d-el/PS3604L/README.md

# PS3604L

## Overview

The PS3604L is a 144 Watt, high performance dc power supply with output current measurement capability in the microampere range.
Combination of bench-top and system features in these dc source.
For more photos to /Photo.

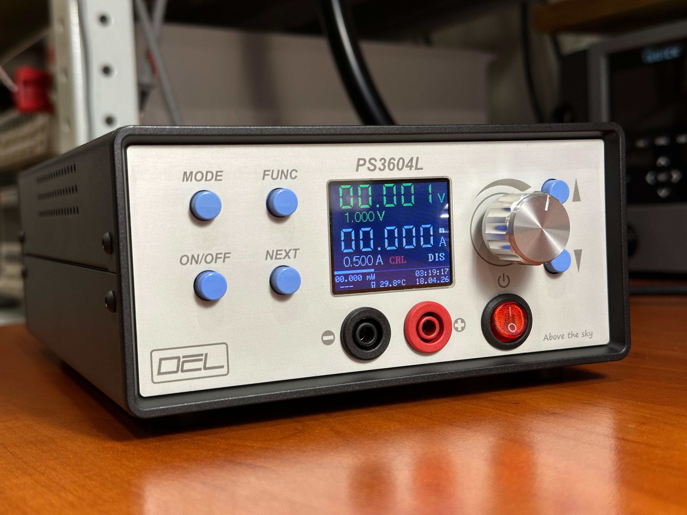
[picture p1: Pictures/face.jpg]


### Convenient bench-top features

- Up to 144 Watts output power
- Easy to use knob for voltage and current settings
- IPS 160x128 pixel front panel display
- Excellent load and line regulation; low ripple and noise
- Measurement capability down to microampere levels
- Light weight

### Flexible system features

- 10/100BASE-T Ethernet

- Modbus TCP for remote programming

- Web interface for monitoring

## Specifications

Unless otherwise noted, specifications apply when measured after a 30-minute warm-up period.

### Performance Specifications

| Parameter | | |
| :--- | ---: | :---: |
| **Output Ratings** | Voltage:<br />Current: | 0 – 36 V<br />0 – 4 A |
| **Programming Accuracy**<br/>(@ 25°C ±5°C) | Voltage:<br />Current: | 5 mV<br />2mA |
| **DC Measurement Accuracy**<br />(@ 25°C ±5°C) | Voltage:<br />Current 0 – 1 mA:<br />Current 0.001 – 4 A: | 5 mV<br />0.01 mA<br />2 mA |
| **Ripple and Noise** | Voltage: (rms)<br />Current (rms): | 0.5 mV<br />1.5 mA |
| **Load Regulation** | TBD | TBD |
| **Line Regulation**<br/>(change in output voltage<br/>or current for any line<br/>change within ratings) | TBD | TBD |
| **Transient Response Time**<br />*1 | | < 50 μs |

1. For the output voltage to recover to its previous level within 0.1% of the voltage rating of the unit or 20 millivolts following a
   change in load current of up to 50% of the output current rating

Short term voltage accuracy:

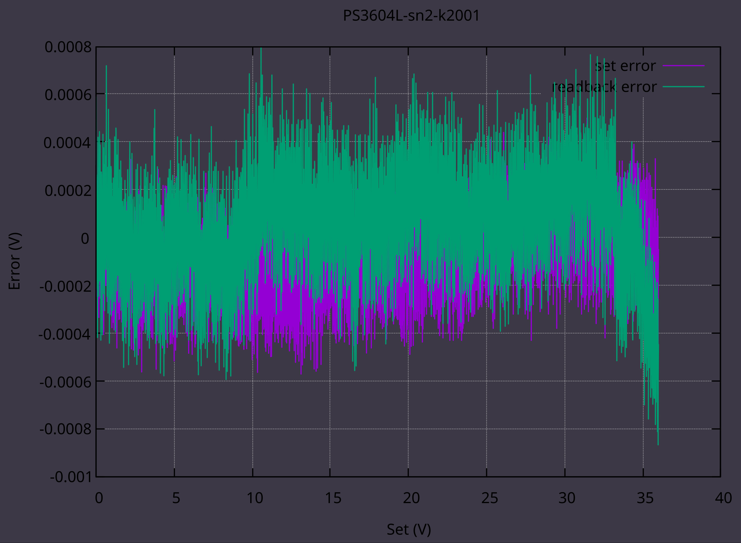
[picture p2: Pictures/Measured/ShortTermVoltAccuracy.JPG]


### Supplemental Characteristics

| Parameter | | |
| --- | ---: | :---: |
| **Input Rating**<br/>(at full load ) | 230 Vac mains: | 230 Vac nominal, 50/60 Hz, 0.85A, 200 VA max. |
| **Average Programming<br/>Resolution** | Voltage (panel):<br />Voltage (remote)<br />Current (panel):<br />Current (remote) | 10 mV<br<br />1 mV<br />1 mA<br />0.1 mA |
| **Output Voltage Rise/Fall Time**<br/>(for a change from 10% to 90% or<br/>90% to 10% of the total excursion) | Rise<br />Fall | < 80 μs<br />< 10 μs |
| **Command Processing Time** | | 10 ms |
| **Isolation to Ground**<br/>(Maximum from either<br/>output terminal to chassis) | | 200 Vdc |
| **Dimensions** | Height:<br />Width:<br />Depth: | 78 mm<br />158 mm<br />268 mm |
| **Net weight** | | 3.850 kg |

------

## Structure

The device has the following modules: Transformer, Rectifier, Regulator, and Front Panel.
The Altium PCB projects can also be opened directly in ECAD Forge for quick browser-based inspection.

Overall structure:



------

## Rectifier

The PS3604LRCF rectifier board rectifies and filters the transformer outputs to provide the raw supply rails for the linear regulator.
Module [schematic](PCB/PS3604LRCF/output/PS3604LRCF.PDF), [ECAD][ecadforge-ps3604lrcf].

------

## Linear regulator

Regulator structure diagram:



Linear regulator is a separate module. Module mounted on back aluminum radiator.
Regulator is four level voltage regulator. Hardware CC/CV detector.
Controlled by STM32F337. Used AD4680 SAR 16bit (18bit oversampling mode) for measure voltage and current.
AD5060 16bit DAC use for current and voltage setpoint.
Fan speed proportional control for minimize sound noise.
Module communicate by UART ModBus.
Module [schematic](PCB/PS3604LR/output/PS3604LR.PDF), [ECAD][ecadforge-ps3604lr].
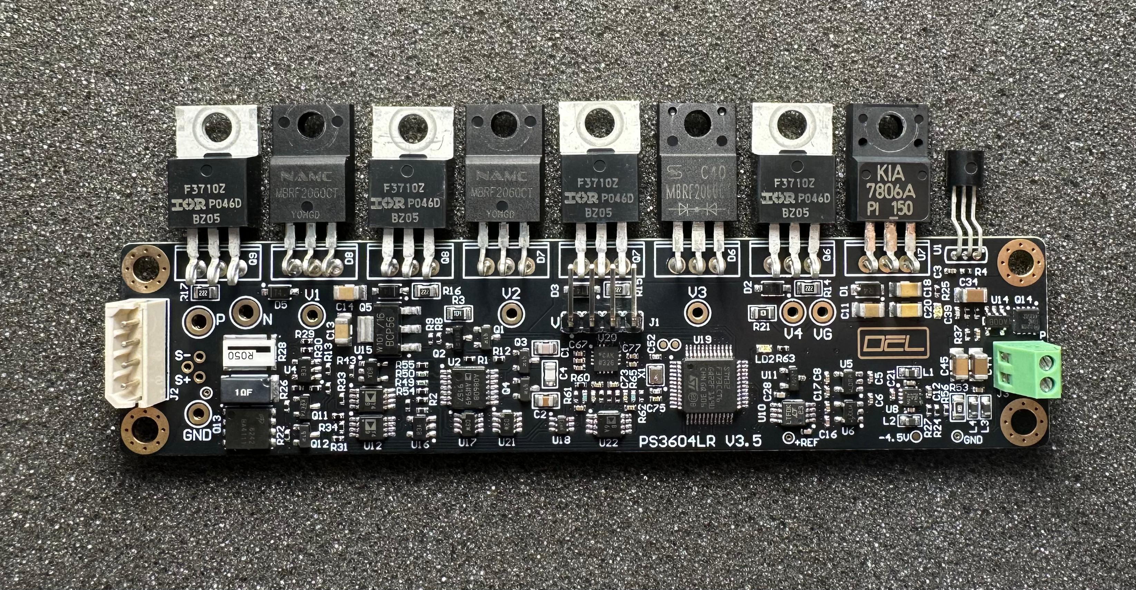
[picture p3: Pictures/regulator_top.jpg]


The PS3604LP output protection board is located between the regulator output and the front terminals.
Module [schematic](PCB/PS3604LP/output/PS3604LP.PDF), [ECAD][ecadforge-ps3604lp].

### Current and voltage measurement firmware path

Using the sample integrator and filter settings, can change the time constant of the voltage and current meter. The ADC sampling period is constant at 0.5 ms.

Normal time constant for regular use if approximately 0.5 s (default value iintegration_size = 1, ifilter_size = 1000). Setting the sample integrator to 100 and the filter length to 1000 make measurement time constsnt of 50 s. This long time constant can be useful for estimating the device's average current consumption.

Measurement firmware path:



### Measurement and comparison of the transient process

Semiconductor resistors and a switch controlled by a functional generator are used as a transient generator.
One resistor with a resistance of 10 Ohms is connected in parallel to the output of the device under test, the second resistor with a nominal value of 7.3 Ohms is connected in parallel to the device under test through a controlled switch.
Current measurement is performed using a Lecroy AP015 current probe. The voltage measurement is performed directly at the terminals of the device under tested using a high impedance passive probe.

Test 1. Both devices are set up the same, 8V 4A, the table shows the graphs of the current rise transient process measurement:

| Agilent 6611C | PS3604L |
| :---: | :---: |
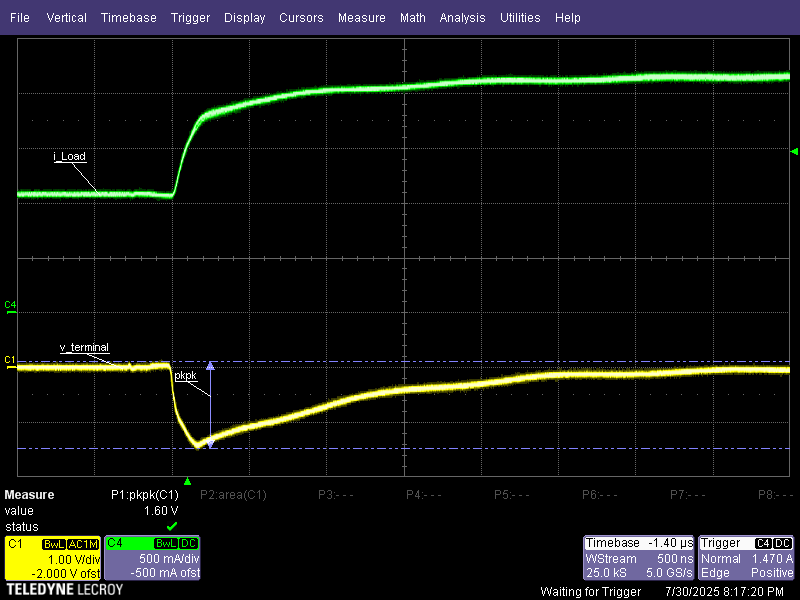
[picture p4: Pictures/v3.3_compare_with_6611C/setting_8V_4A/6611C_rs.png]
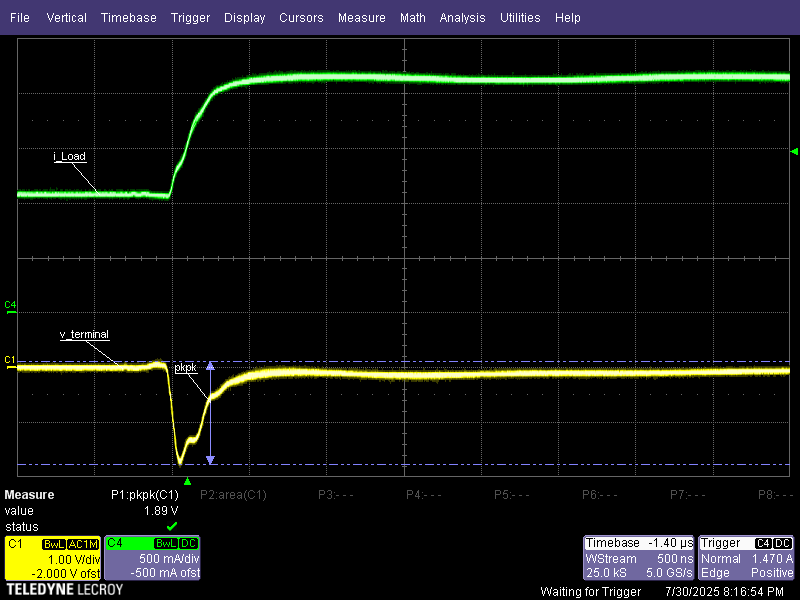
[picture p5: Pictures/v3.3_compare_with_6611C/setting_8V_4A/3604L_rs.png]
|  |  |

Test 2. Both devices are set up the same, 8V 4A, the table shows the graphs of the current fall transient process measurement:

| Agilent 6611C | PS3604L |
| :---: | :---: |
| | |
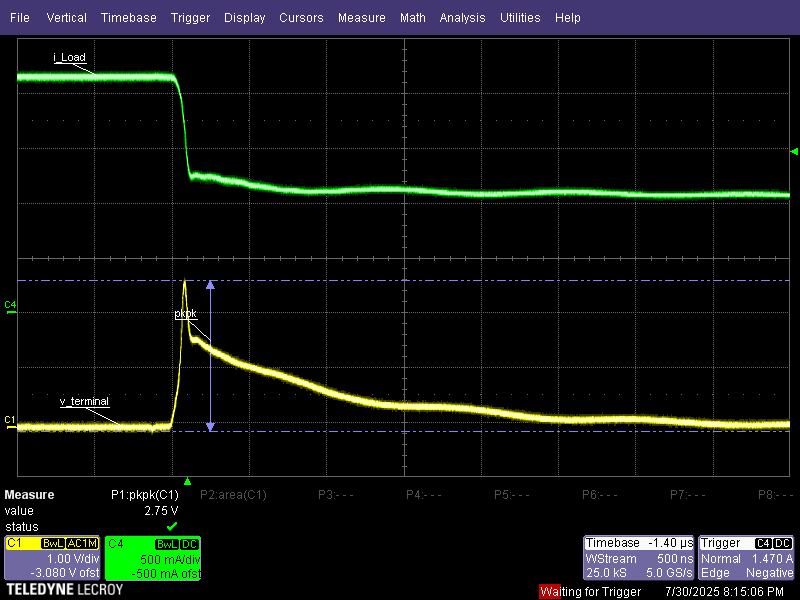
[picture p6: Pictures/v3.3_compare_with_6611C/setting_8V_4A/6611C_fl.png]
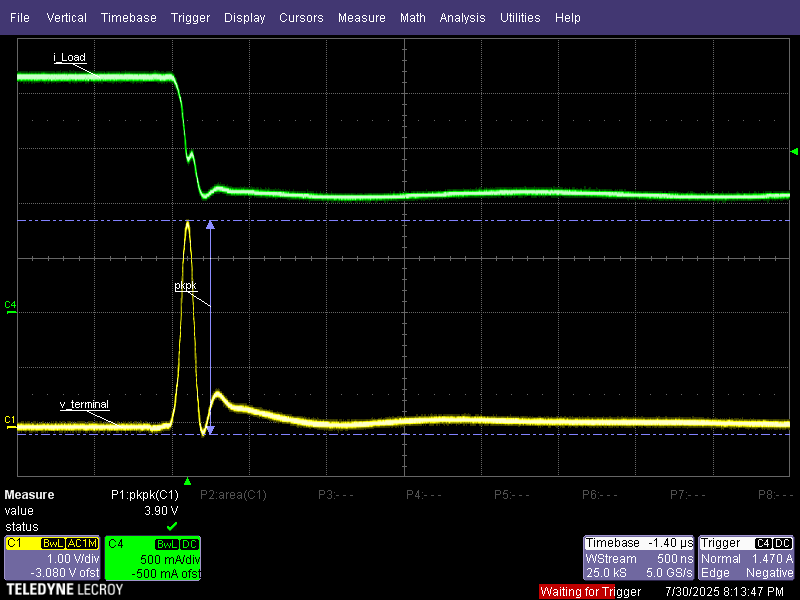
[picture p7: Pictures/v3.3_compare_with_6611C/setting_8V_4A/3604L_fl.png]
|  |  |

Test 3. Both devices are set up the same, 8V 1A, the table shows the graphs of the current rise transient process measurement:

| Agilent 6611C | PS3604L |
| :---: | :---: |
| | |
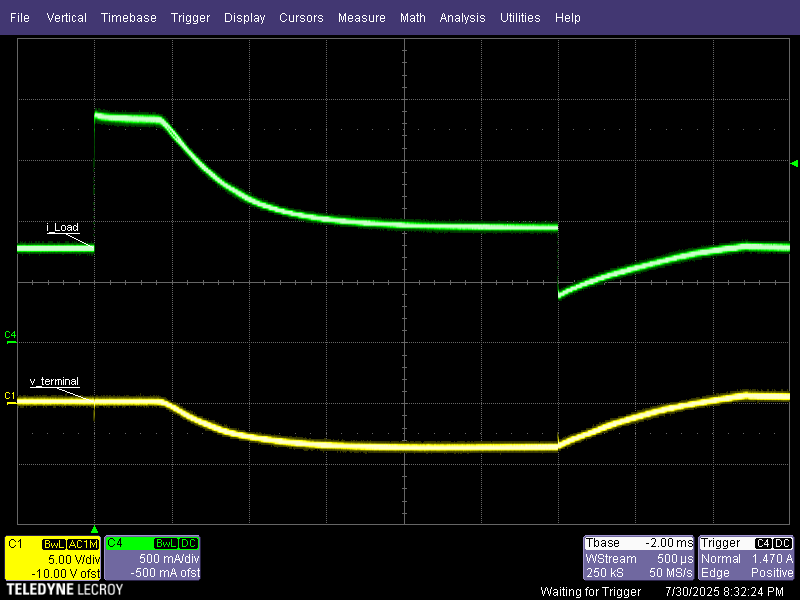
[picture p8: Pictures/v3.3_compare_with_6611C/setting_8V_1A/6611C.png]
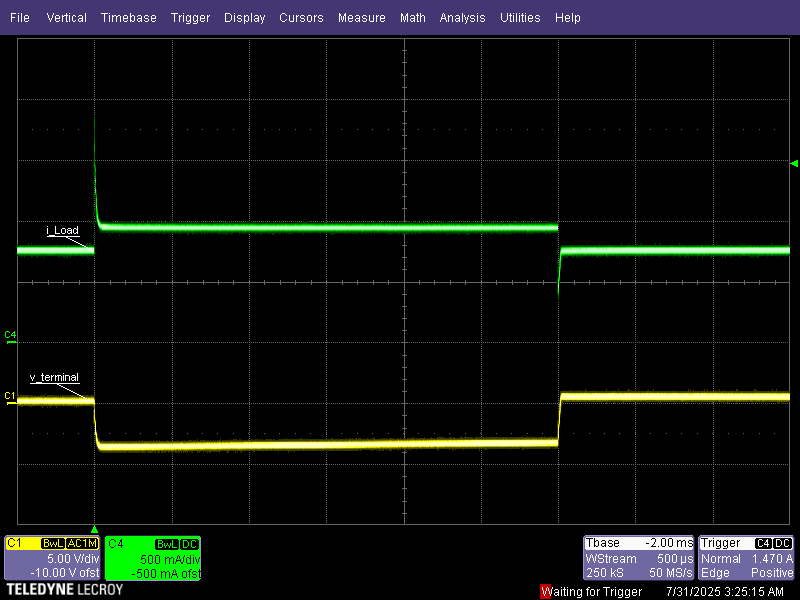
[picture p9: Pictures/v3.3_compare_with_6611C/setting_8V_1A/3604L.png]
|  |  |

In more detail, PS3604L:

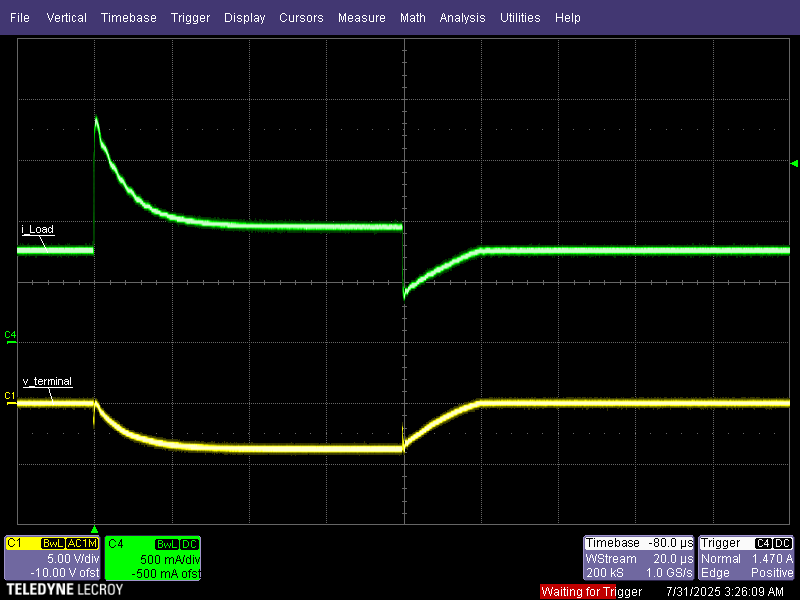
[picture p10: Pictures/v3.3_compare_with_6611C/setting_8V_1A/3604L_det.png]


------

## Front panel

Panel structure:



Front panel is GUI and Ethernet bridge.  
Build on STM32F407 MCU, LAN8720 as Eth PHY.  
Module [schematic](PCB/PS3604LF/output/PS3604LF.PDF), [ECAD][ecadforge-ps3604lf].

The PS3604LD display board carries the LCD connector and backlight interface used by the front panel.
Module [schematic](PCB/PS3604LD/output/PS3604LD.PDF), [ECAD][ecadforge-ps3604ld].
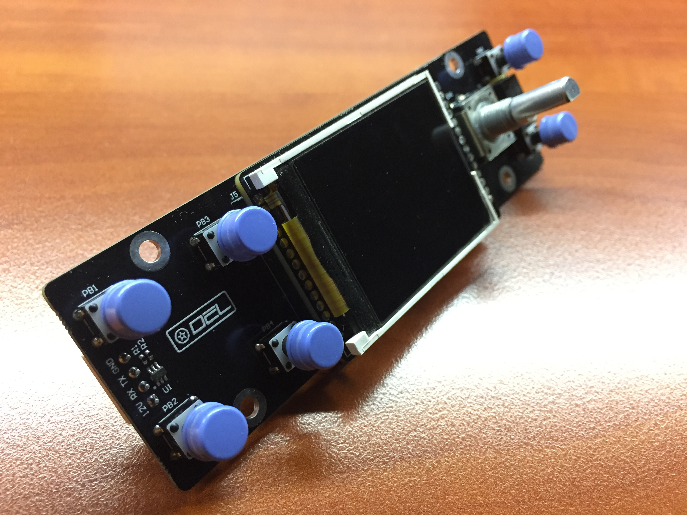
[picture p11: Pictures/IMG_4574.JPG]


------

## Extra application

1. Measure series output characteristics of a MOSFET. [Link](/Firmware/Scripts/x-curve.py) to script.



------

## User manual

Key shortcuts:

- FUNC-MODE -- settings menu tree
- FUNC-NEXT -- next preset (only when the output is turned off)
- FUNC-UP -- set current measurement High range
- FUNC-DOWN -- set current measurement Auto range.

Settings menu tree:

```
Root
├─ Regulator
│  ├─ cRange
│  ├─ Wire
│  │  ├─ Compensation
│  │  ├─ Wire
│  │  └─ Res
│  ├─ Vmeter
│  ├─ MicroAmeter
│  ├─ Ameter
│  ├─ Info
│  │  ├─ Serial
│  │  ├─ CalibrationTime
│  │  ├─ Vdc
│  │  ├─ Ths
│  │  ├─ Tsh
│  │  └─ Tref
│  ├─ Acquisition
│  │  ├─ vIntegration
│  │  ├─ vFilter
│  │  ├─ iIntegration
│  │  └─ iFilter
│  └─ Save
├─ DateTime
│  ├─ Clock
│  ├─ Time Zone
│  ├─ DST
│  ├─ Start
│  └─ End
├─ LAN
│  ├─ DHCP
│  ├─ IP address
│  ├─ Subnet mask
│  ├─ Gateway
│  ├─ DNS IP
│  ├─ Info
│  │  ├─ IP address
│  │  ├─ Subnet mask
│  │  ├─ Gateway
│  │  ├─ DNS IP
│  │  └─ MAC address
└─ Bright
```

### Wire resistance compensation

Short the ends of the wires. Set the **/Regulator/Wire/Compensation** parameter to On. Adjust the **Wire** value so that the result value **Res** is zero.

### Acquisition constant time

For voltage meter set **/Regulator/Acquisition/vIntegration** and  **/Regulator/Acquisition/vFilter**, this parameter is saved in Panel. Result constant time is **0.5 ms * vIntegration * vFilter**.

For current meter set **/Regulator/Acquisition/iIntegration** and  **/Regulator/Acquisition/iFilter**, this parameter is saved in Panel. Result constant time is **0.5 ms * iIntegration * iFilter**.

[ecadforge-ps3604lrcf]: https://ecadforge.app/?url=https%3A%2F%2Fgithub.com%2Fd-el%2FPS3604L%2Ftree%2Fmaster%2FPCB%2FPS3604LRCF
[ecadforge-ps3604ld]: https://ecadforge.app/?url=https%3A%2F%2Fgithub.com%2Fd-el%2FPS3604L%2Ftree%2Fmaster%2FPCB%2FPS3604LD
[ecadforge-ps3604lf]: https://ecadforge.app/?url=https%3A%2F%2Fgithub.com%2Fd-el%2FPS3604L%2Ftree%2Fmaster%2FPCB%2FPS3604LF
[ecadforge-ps3604lp]: https://ecadforge.app/?url=https%3A%2F%2Fgithub.com%2Fd-el%2FPS3604L%2Ftree%2Fmaster%2FPCB%2FPS3604LP
[ecadforge-ps3604lr]: https://ecadforge.app/?url=https%3A%2F%2Fgithub.com%2Fd-el%2FPS3604L%2Ftree%2Fmaster%2FPCB%2FPS3604LR
