d-el/PS3604L/Other/Trans.jpg

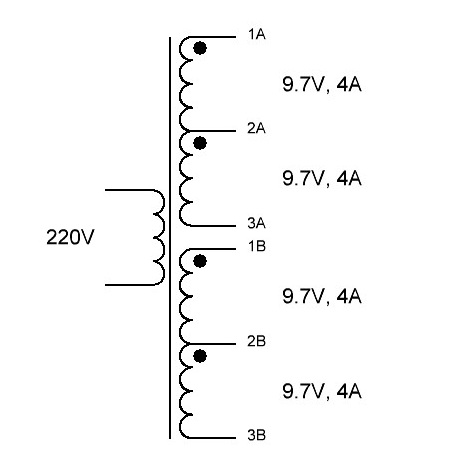
Other/Trans.jpg
