d-el/PS3604L/Pictures/IMG_4729.JPG

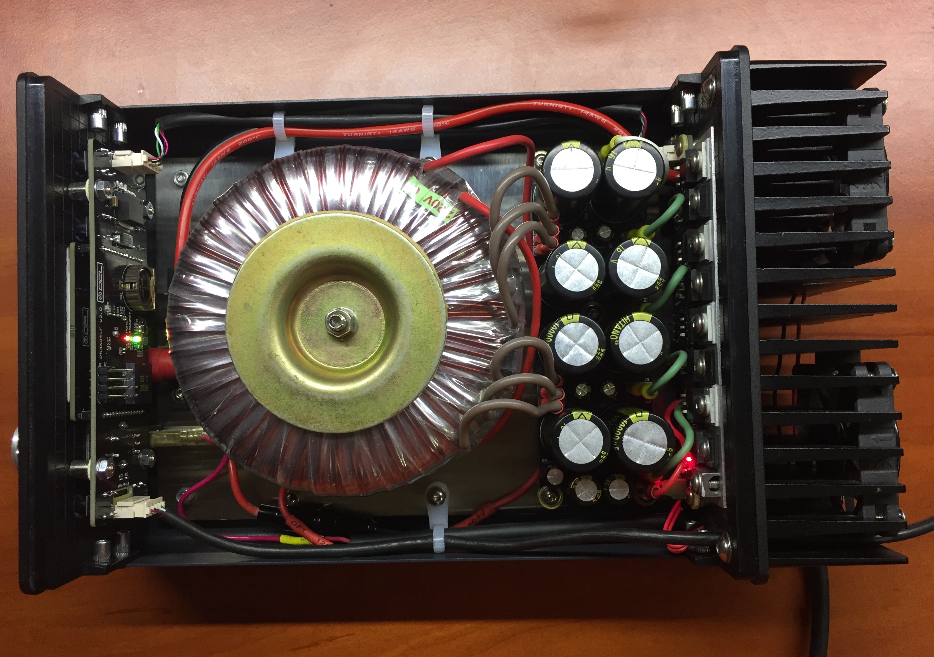
Pictures/IMG_4729.JPG
