d-el/PS3604L/Pictures/IMG_E4569.JPG

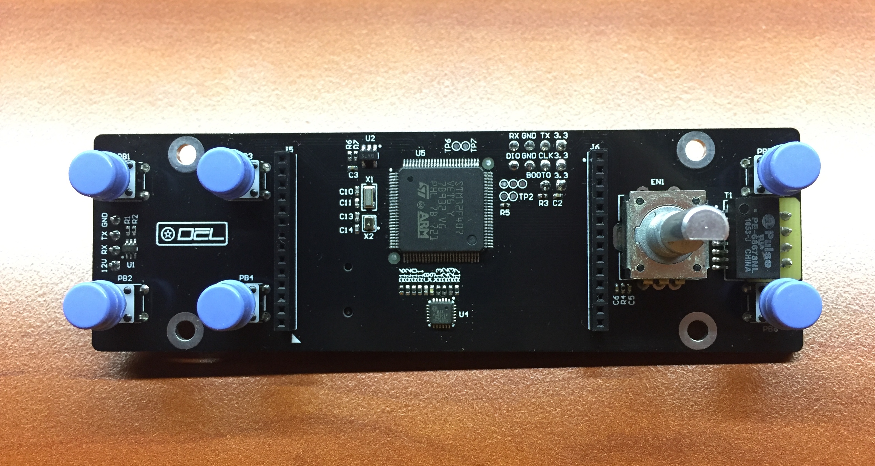
Pictures/IMG_E4569.JPG
