d-el/PS3604L/Pictures/IMG_E4571.JPG

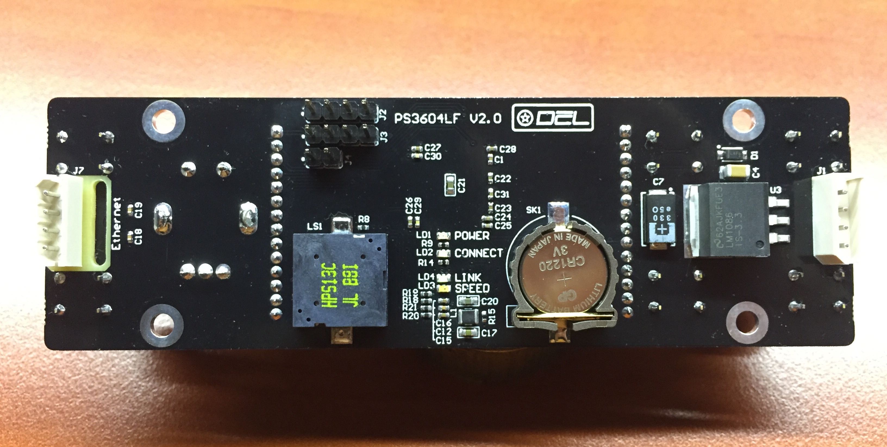
Pictures/IMG_E4571.JPG
