d-el/PS3604L/Pictures/IMG_E4575.JPG

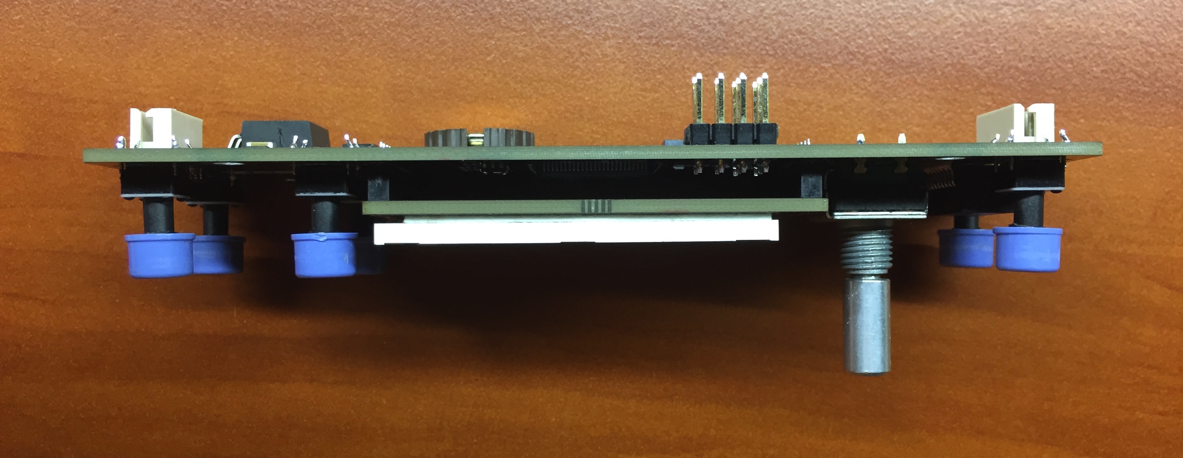
Pictures/IMG_E4575.JPG
