d-el/PS3604L/Pictures/IMG_E4589.JPG

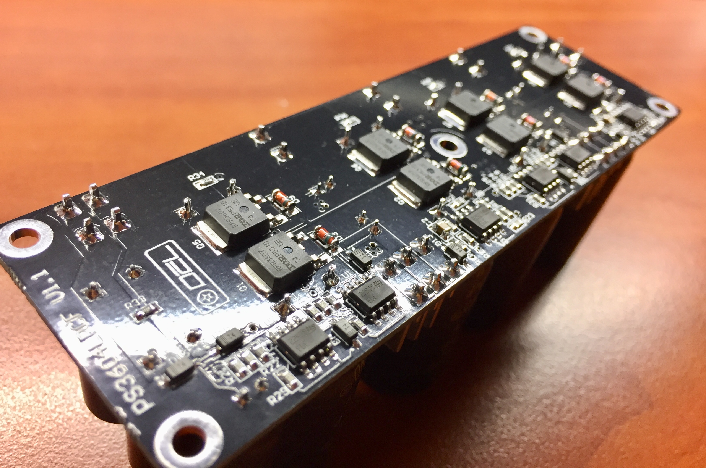
Pictures/IMG_E4589.JPG
