d-el/PS3604L/Pictures/IMG_E4590.JPG

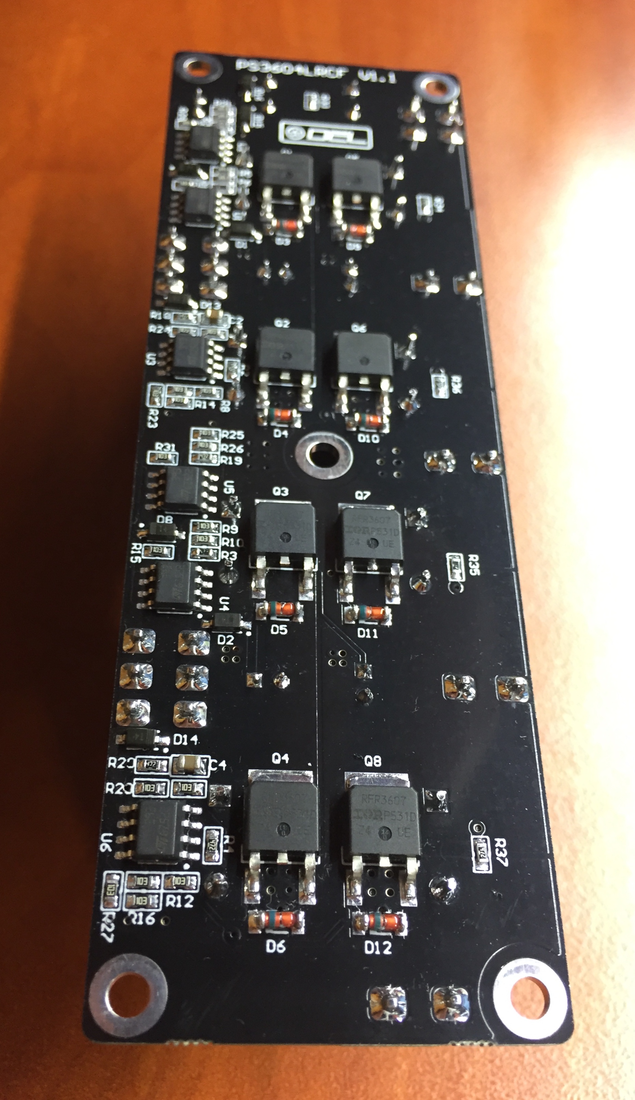
Pictures/IMG_E4590.JPG
