d-el/PS3604L/Pictures/IMG_E4592.JPG

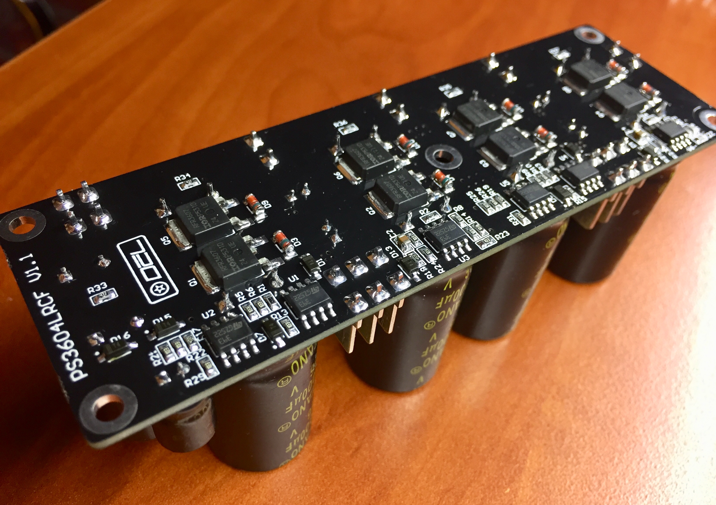
Pictures/IMG_E4592.JPG
