d-el/PS3604L/Pictures/IMG_E4593.JPG

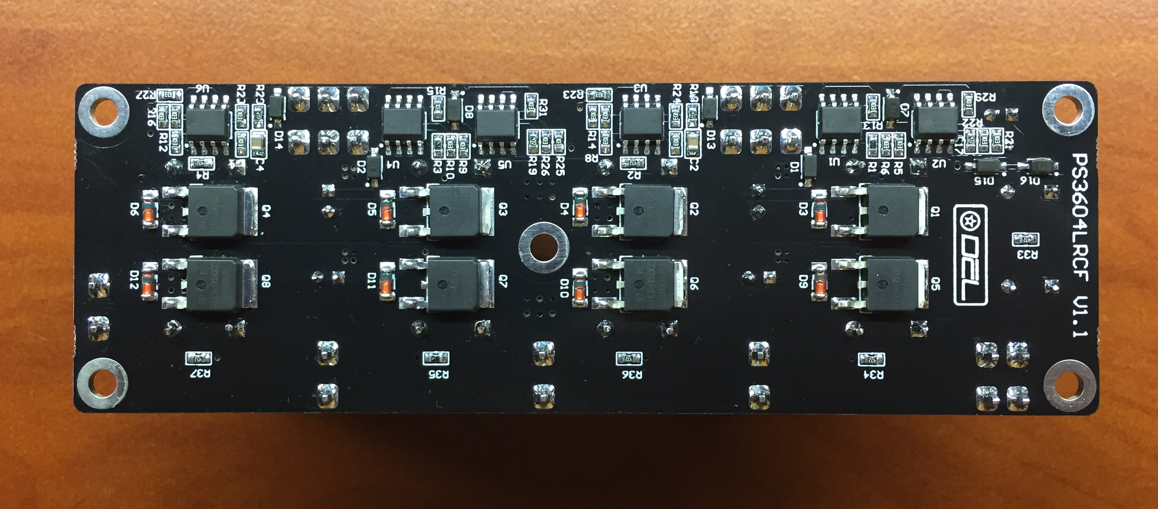
Pictures/IMG_E4593.JPG
