d-el/PS3604L/Pictures/IMG_E4594.JPG

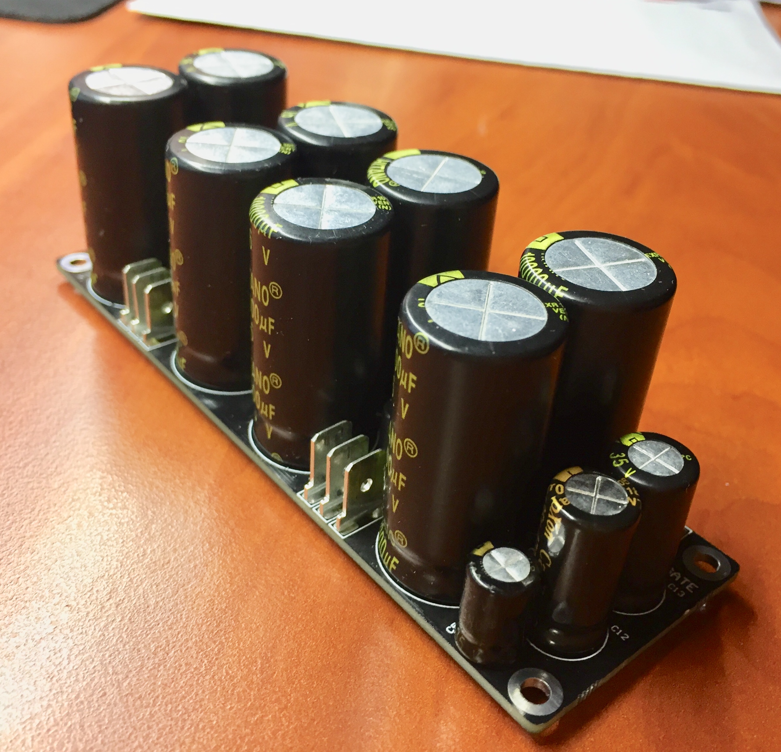
Pictures/IMG_E4594.JPG
