d-el/PS3604L/Pictures/IMG_E4596.JPG

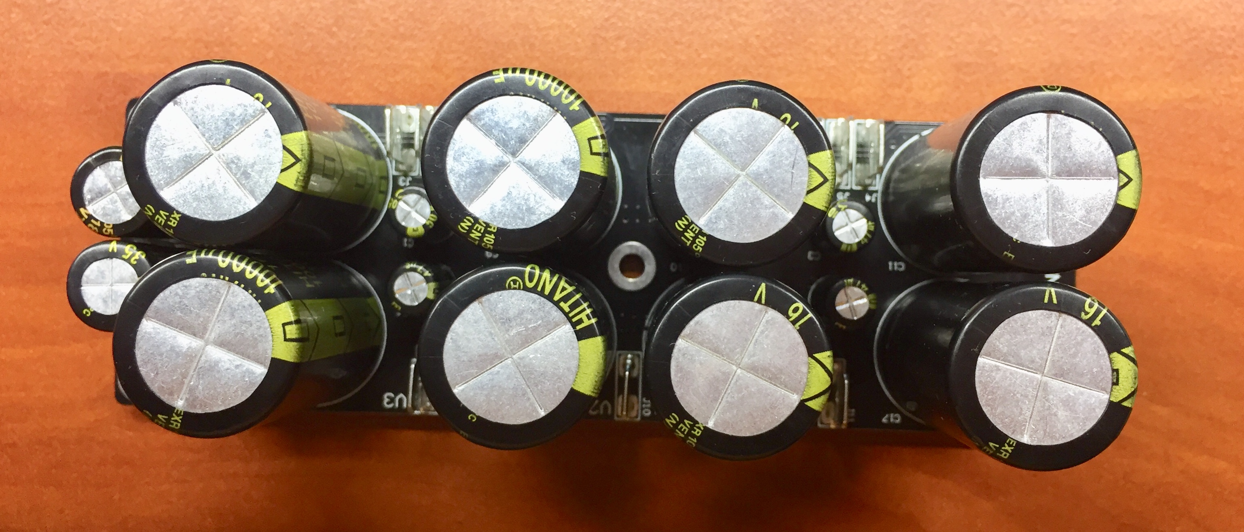
Pictures/IMG_E4596.JPG
