d-el/PS3604L/Pictures/regulator_bottom.jpg

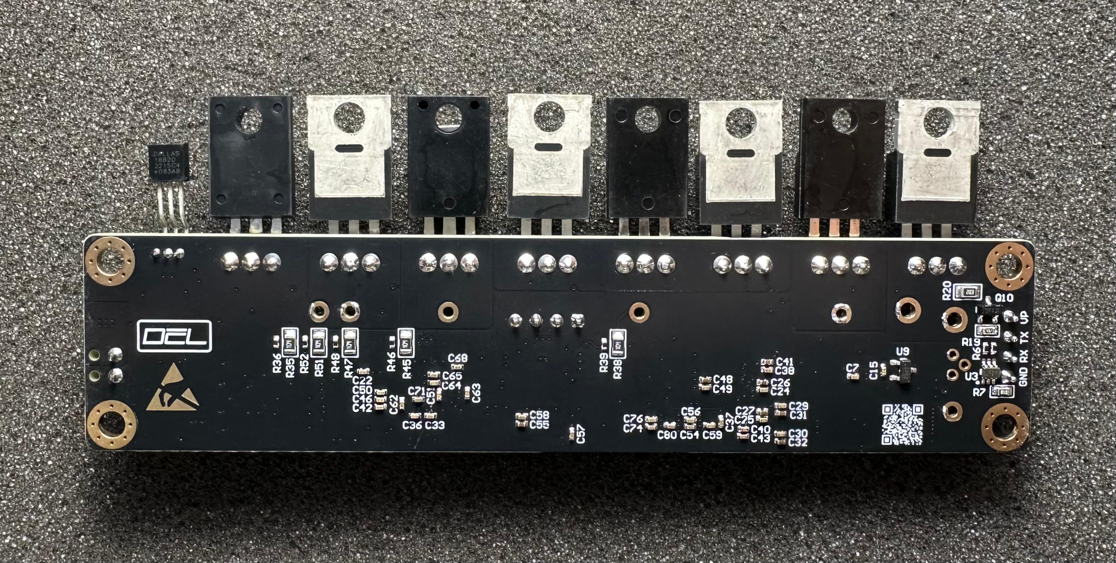
Pictures/regulator_bottom.jpg
