d-el/PS3604L/PCB/PS3604LR/output/BOM/Bill of Materials-PS3604LR.xlsx

Designator | Comment | Footprint | Part Number | Part Description | Quantity
B1, B2, B3, B4, B5, B6 | VG, V4, V3, V2, V1, GND | c250h130 | PLATED_HOLE1.3_PAD2.5 | Plated Through Hole: Hole Dia.=1.3mm Pad Dia.=2.5mm | 6
B7, B8 | P, N | c320h180 | PLATED_HOLE1.8_PAD3.2 | Plated Through Hole: Hole Dia.=1.8mm Pad Dia.=3.2mm | 2
B9, B10, B11 | Plated Hole | c150h100 | PLATED_HOLE1.0_PAD1.5 | Plated Through Hole: Hole Dia.=1.0mm Pad Dia.=1.5mm | 3
C1 | 150p | CAPC2012X135N | CC0805_150PF_50V_5%_NP0 | SMD Multilayer Chip Ceramic Capacitor | 1
C2 | 680p | CAPC2012X135N | CC0805_680PF_50V_5%_NP0 | SMD Multilayer Chip Ceramic Capacitor | 1
C3, C5, C6, C10, C12, C16, C17, C19, C21, C23, C26, C27, C31, C32, C35, C38, C43, C48, C54, C55, C66, C67, C74, C77, C78 | 1u | CAPC1005X55N | CC0402_1UF_10V_20%_X5R | SMD Multilayer Chip Ceramic Capacitor | 25
C4 | 330p | CAPC2012X135N | CC0805_330PF_50V_5%_NP0 | SMD Multilayer Chip Ceramic Capacitor | 1
C7, C15, C22, C24, C25, C29, C30, C37, C40, C41, C47, C49, C56, C57, C58, C59, C62, C63, C65, C68, C69, C70, C71, C75, C76, C79, C80 | 100n | CAPC1005X55N | CC0402_100NF_50V_10%_X7R | SMD Multilayer Chip Ceramic Capacitor | 27
C8, C9 | 10n | CAPC1005X55N | CC0402_10NF_50V_10%_X7R | SMD Multilayer Chip Ceramic Capacitor | 2
C11 | 4.7u | CAPC3216X140N | CC1206_4.7UF_50V_10%_X7R | SMD Multilayer Chip Ceramic Capacitor | 1
C13, C14 | 2.2u | CAPC3216X140N | CC1206_2.2UF_100V_10%_X7R | SMD Multilayer Chip Ceramic Capacitor | 2
C18, C20 | 10u | CAPC3216X140N | CC1206_10UF_16V_10%_X7R | SMD Multilayer Chip Ceramic Capacitor | 2
C28, C64 | 4.7u | CAPC1005X55N | CC0402_4.7UF_10V_20%_X5R | SMD Multilayer Chip Ceramic Capacitor | 2
C33, C36, C42, C46, C50, C51 | 22n | CAPC1005X55N | CC0402_22NF_16V_10%_X7R | SMD Multilayer Chip Ceramic Capacitor | 6
C34, C44, C45 | 22u | CAPC3216X100N | CC1206_22UF_16V_20%_X5R | SMD Multilayer Chip Ceramic Capacitor | 3
C39, C60, C61 | 1n | CAPC1005X55N | CC0402_1NF_50V_5%_NP0 | SMD Multilayer Chip Ceramic Capacitor | 3
C52, C53 | 6.8p | CAPC1005X55N | CC0402_6.8PF_50V_0.5PF_NP0 | SMD Multilayer Chip Ceramic Capacitor | 2
C72, C73 | 220n | CAPC1005X55N | CC0402_220NF_6.3V_10%_X5R | SMD Multilayer Chip Ceramic Capacitor | 2
D1 | MBR140SFT1G | SOD-123FL | MBR140SFT1G | Schottky Power Rectifier | 1
D2, D3, D4, D5 | 1N4148W | SOD3715X145N | 1N4148W | Small Signal Diode | 4
D6, D7, D8 | MBRF2060 | TO-220-H-OUTSIDE | MBRF2060CTG_h_outside | Switch-mode Schottky Power Rectifier (Common Cathode) | 3
J1 | Header 4 | 3M_929550-0104-EU | 3M_929550-0104-EU | 10 Contacts - Horizontal Contacts Straight Strip Header Pitch 2.54 | 1
J2 | SPOX | MOLEX_22-03-5045 | MOLEX_22-03-5045 | 2.50mm Pitch SPOX Wire-to-Board Header, Vertical, Shrouded, 4 Circuits, Tin (Sn) Plating | 1
J3 |  | PHOENIX_1725656 | PHOENIX_1725656 | 6A, 63V, Terminal Block, Pitch 2.54mm, 2 Positions, Screw Connection | 1
L1, L2 | 10uH | INDC1608X95N | IND0603_10UH_MURATA_LQM18FN100M00D | Chip Inductors | 2
L3, L4 | 220R@100MHz | INDC1608X95N | FB0603_SAMSUNG_CIS10P221NC | SMT Ferrite bead | 2
LD1 | Red | LEDC1608X80N_RED | LED_OF-SMD1608R | Surface Mount Red LED (0603 Case) | 1
LD2 | Blue | LEDC1608X80N_BLUE | LED_OF-SMD1608B | Surface Mount Red LED (0603 Case) | 1
MH1, MH2, MH3, MH4 | Non Plated Hole | MTG600H320V8P | NON-PLATED_HOLE3.2_PAD6.0_8p | Through Hole: Hole Dia.=3.2mm Pad Dia.=6mm + 6 Via Dia.=0.3mm | 4
Q1, Q3, Q4, Q12 | MMBT5551 | SOT95P240X130-3N | MMBT5551L | 160V 600A NPN General Purpose Amplifier | 4
Q2, Q10 | BSS139 | SOT95P240X110-3N | BSS139 | 250V 0.1A N-Channel MOSFET Depletion-mode | 2
Q5 | BCP56 | SOT230P700X180-4N | BCP56 | 80V 1A NPN Medium Power Transistor | 1
Q6, Q7, Q8, Q9 | IRF3710 | TO-220-H-OUTSIDE | IRF3710_h_outside | 100V 57A 0.023 Ohm N-Channel Power MOSFET | 4
Q11 | IRLML0100TRPBF | SOT95P237X112-3N | IRLML0100TRPBF | 100V 1.6A N-Channel HEXFET® Power MOSFET | 1
Q13 | CSD18531 | DFN-5X6-8L | CSD18531Q5A | 60V 100A 4mOhm N-Channel NexFET | 1
Q14 | IRFHM9331 | PQFN50P300X300X100_HS-9N | IRFHM9331TRPbF | -30V 11A 0.014 Ohm P-Channel MOSFET | 1
R1, R2, R12 | 2k2 | RESC1005X40N | R0402_2K2_1%_0.0625W_100PPM | General Purpose Thick Film Chip Resistor | 3
R3, R35, R38, R45, R47, R51 | 100k | RESC2012X60N | R0805_100K_1%_0.125W_100PPM | General Purpose Thick Film Chip Resistor | 6
R4, R8, R25, R63 | 1k | RESC1005X40N | R0402_1K_1%_0.0625W_100PPM | General Purpose Thick Film Chip Resistor | 4
R5, R6, R29, R30, R31, R32, R57, R59 | 100 | RESC1005X40N | R0402_100R_1%_0.0625W_100PPM | General Purpose Thick Film Chip Resistor | 8
R7 | 0.1 | RESC1608X55N | R0603_0R1_1%_0.1W_100PPM | General Purpose Thick Film Chip Resistor | 1
R9, R44 | 8k2 | RESC1005X40N | R0402_8K2_1%_0.0625W_100PPM | General Purpose Thick Film Chip Resistor | 2
R10, R43 | 12k | RESC1005X40N | R0402_12K_1%_0.0625W_100PPM | General Purpose Thick Film Chip Resistor | 2
R11 | 180 | RESC1005X40N | R0402_180R_1%_0.0625W_100PPM | General Purpose Thick Film Chip Resistor | 1
R13 | 75k | RESC1005X40N | R0402_75K_1%_0.0625W_100PPM | General Purpose Thick Film Chip Resistor | 1
R14, R15, R16, R17 | 2k2 | RESC2012X60N | R0805_2K2_1%_0.125W_100PPM | General Purpose Thick Film Chip Resistor | 4
R18, R22, R23 | 2k | RESC1005X40N | R0402_2K_1%_0.0625W_100PPM | General Purpose Thick Film Chip Resistor | 3
R19 | 1k | RESC1608X55N | R0603_1K_1%_0.1W_100PPM | General Purpose Thick Film Chip Resistor | 1
R20 | 20k | RESC2012X60N | R0805_20K_1%_0.125W_100PPM | General Purpose Thick Film Chip Resistor | 1
R21 | 100 | RESC2012X60N | R0805_100R_1%_0.125W_100PPM | General Purpose Thick Film Chip Resistor | 1
R24 | 43k | RESC1005X40N | R0402_43K_1%_0.0625W_100PPM | General Purpose Thick Film Chip Resistor | 1
R26 | 1 | RESC6331X70N | R2512_1R0_1%_1W_100PPM | Current Sense Resistors | 1
R27 | 120k | RESC1005X40N | R0402_120K_1%_0.0625W_100PPM | General Purpose Thick Film Chip Resistor | 1
R28 | 50m | FC4L64_OHM | FC4L64R050FER | FC4L Four Terminal Current Sense resistor | 1
R33 | 680 | RESC1005X40N | R0402_680R_0.1%_0.063W_10PPM | General Purpose Thick Film Chip Resistor | 1
R34 | 255 | RESC1005X40N | R0402_255R_0.1%_0.063W_10PPM | General Purpose Thick Film Chip Resistor | 1
R36, R39, R46, R48, R52, R56 | 4k7 | RESC1005X40N | R0402_4K7_1%_0.0625W_100PPM | General Purpose Thick Film Chip Resistor | 6
R37, R42, R61, R62 | 10k | RESC1005X40N | R0402_10K_1%_0.0625W_100PPM | General Purpose Thick Film Chip Resistor | 4
R40 | 12k | RESC1005X40N | R0402_12K_0.1%_0.063W_10PPM | General Purpose Thick Film Chip Resistor | 1
R41 | 75 | RESC1005X40N | R0402_75R_0.1%_0.063W_10PPM | General Purpose Thick Film Chip Resistor | 1
R49, R50 | 100k | RESC1005X40N | R0402_100K_0.1%_0.063W_10PPM | General Purpose Thick Film Chip Resistor | 2
R53 | 0R5 | RESC2012X60N | R0805_0R5_1%_0.125W_200PPM | Thin Film Chip Resistor | 1
R54, R55 | 8k45 | RESC1005X40N | R0402_8K45_0.1%_0.063W_10PPM | General Purpose Thick Film Chip Resistor | 2
R58, R60 | 0 | RESC1005X40N | R0402_0R_JUMPER | 1A (0.05R Max DC Resistance) Zero Ohm Jumper | 2
R64, R65 | 13k | RESC1005X40N | R0402_13K_1%_0.0625W_100PPM | General Purpose Thick Film Chip Resistor | 2
TP1, TP2, TP3, TP4, TP5, TP6 | GND, -4.5V, +REF, Test Point | TP_SMD_800 | TP_SMD_0.8MM | 0.8mm round SMD Pad | 6
U1 | DS18B20 | TO-92-H-OUTSIDE | DS18B20_h_outside | Programmable Resolution 1-Wire Digital Thermometer 1-Wire Digital Thermometer | 1
U2 | AD8608 | SOP65P640X110-14N | AD8608ARUZ-REEL | Precision, Low Noise, CMOS, Rail-to-Rail, Input/Output Operational Amplifiers | 1
U3 | NUP4202 | SOT65P220X110-6N | NUP4202W1 | ESD Protection Diode, Low Clamping Voltage | 1
U4, U15, U16 | AD8605 | SOT95P280X145-5N | AD8605ARTZ | Precision, Low Noise, CMOS, Rail-to-Rail, Input/Output Operational Amplifiers | 3
U5 | LP2985A-33DBV | SOT95P280X145-5N | LP2985A-33DBV | 3.3V, 150mA Low-Noise Low-Dropout Regulator Whit Shutdown | 1
U6 | LP2985A-50DBV | SOT95P280X145-5N | LP2985A-50DBV | 5V, 150mA Low-Noise Low-Dropout Regulator Whit Shutdown | 1
U7 | KIA7812 | TO-220-H-OUTSIDE | KIA7812API_h_outside | 3-Terminal 12V 1A Positive Voltage Regulator | 1
U8 | LM27761 | SON50P200X200X80-9N | LM27761 | LM27761 Low-Noise, Regulated, Switched-Capacitor Voltage Inverter | 1
U9, U11 | TMP236 | SOT95P230X110-3N | TMP236A2DBZR | Low-Power, High-Accuracy Analog Output Temperature Sensors | 2
U10 | LTC6655BHMS8-3.3 | SOP65P490X110-8BN | LTC6655BHMS8-3.3 | 0.25ppm Noise, Low Drift Precision References | 1
U12, U13 | AD8421 | SOP65P490X110-8BN | AD8421BRMZ-R | 3 nV/√Hz, Low Power Instrumentation Amplifier | 2
U14 | LMC7101 | SOT95P280X145-5N | LMC7101AIM5X/NOPB | 2.7-15V, Rail-to-Rail I/O Amplifier | 1
U17, U21 | AD5060 | SOT65P280X145-8N | AD5060BRJZ | Fully Accurate 16-Bit VOUT DAC, SPI Interface 2.7 V to 5.5 V, in an SOT-23 | 2
U18 | TS5A3159 | SOT65P210X110-6N | TS5A3159DCKR | 1-Ω SPDT Analog Switch | 1
U19 | STM32F373CCT6 | QFP50P900X900X160-48N | STM32F373CCT6 | ARM®Cortex®-M4 32b MCU+FPU, up to 256KB Flash+32KB SRAM, timers, 4 ADCs (16-bit Sig. Delta / 12-bit SAR), 3 DACs, 2 comp., 2.0-3.6 V | 1
U20 | AD4680 | QFN50P300X300X80-17N-D | AD4680 | Differential Inputs, 1 MSPS/500 kSPS, Dual Simultaneous Sampling SAR ADCs | 1
U22 | AD8606 | SOP65P490X110-8BN | AD8606ARMZ-REEL | Precision, Low Noise, CMOS, Rail-to-Rail, Input/Output Operational Amplifiers | 1
X1 | 24MHZ | OSCCC160X200X65-4N | 24MHZ_XRCGB24M000F3M00R0 | ± 30ppm at (25±3°C), -30°C to +85°C, 6pF, Ceramic SMD Crystal, Type HCR2016 | 1
