d-el/PS3604L/(list of files, cad)

Other CAD files:
OrCad/regulator/PAGE1.DXF
