d-el/PS3604L/PCB/PS3604LP/output/PS3604LP.PDF

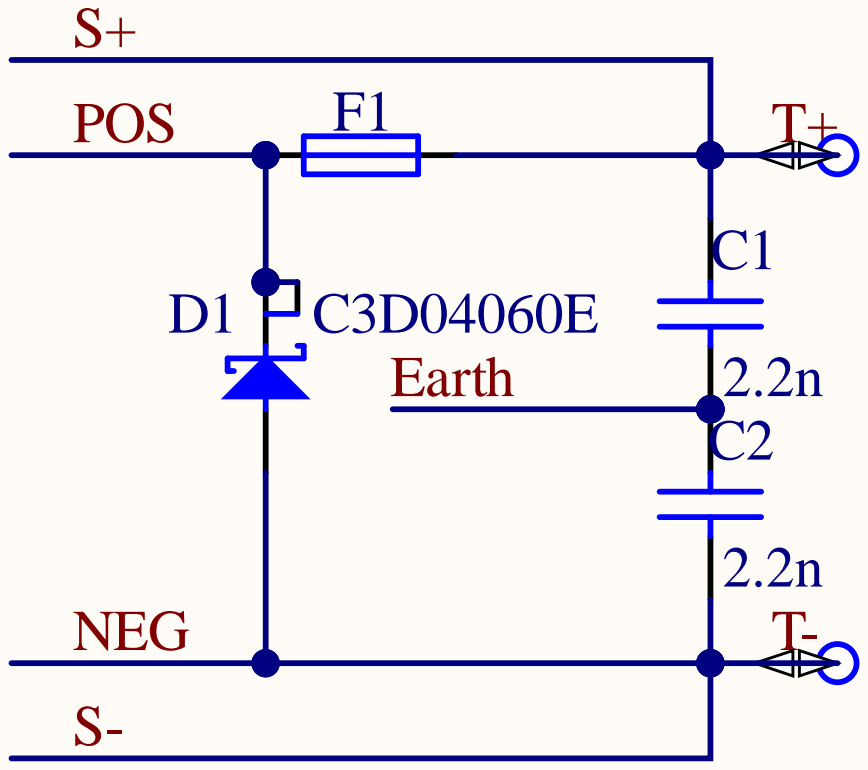
[picture p24: page 1]

Designator | Comment | Footprint | Part Number | Part Description | Quantity
B1, B2 | Plated Hole | MTG420_550 | PLATED_HOLE4.2_PAD5.5 | Plated Through Hole: Hole Dia.=4.2mm Pad Dia.=5.5mm | 2
C1, C2 | 2.2n | CAPC4532X250N | CC1812_2.2NF_1000V_10%_X7R | SMD Multilayer Chip Ceramic Capacitor | 2
D1 | C3D04060E | TO228P972X240-3N-R540X510 | C3D04060E | Silicon Carbide Schottky Diode | 1
F1 | 0.5A-125V | FUSE_LITTELFUSE_0154 | FUSE_LITTELFUSE_0154.500DR | SMF OMNI-BLOK® Very Fast-Acting Fuse and Holder | 1

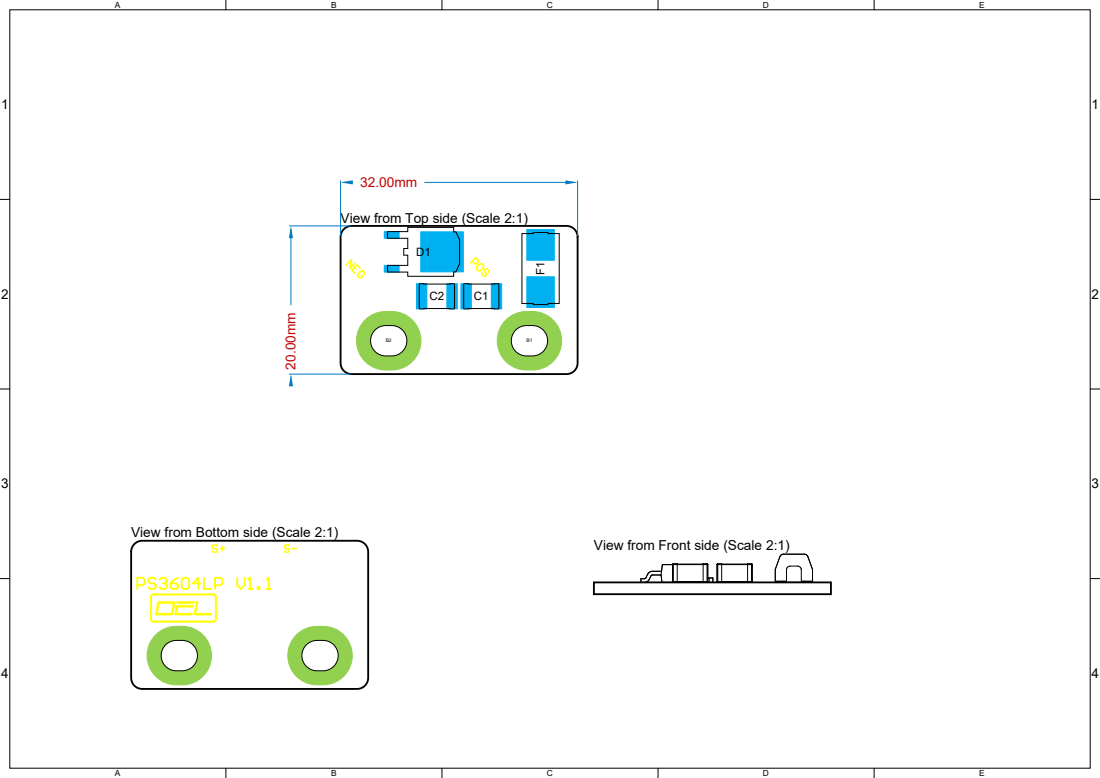
[picture p25: page 3]

View from Top side (Scale 2:1)

View from Bottom side (Scale 2:1)

View from Front side (Scale 2:1)

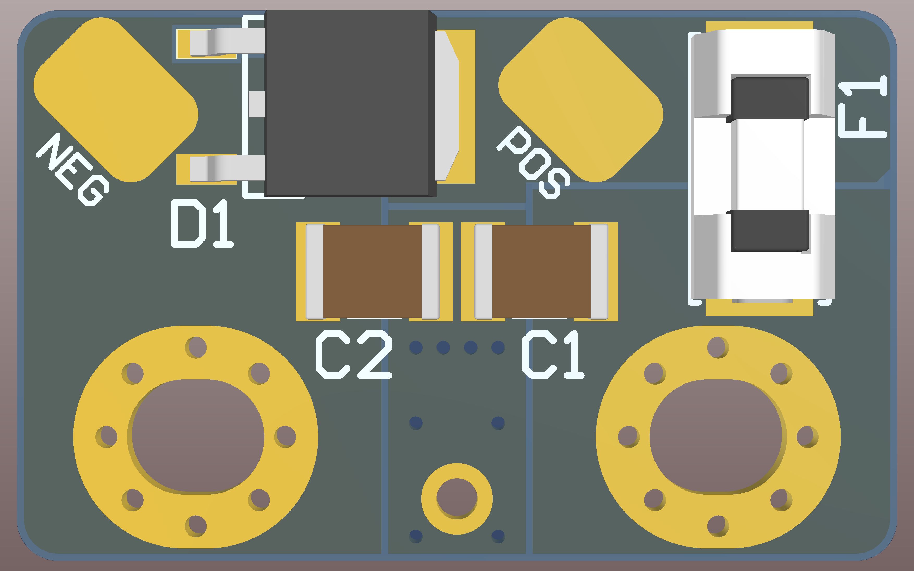
[picture p26: page 4]

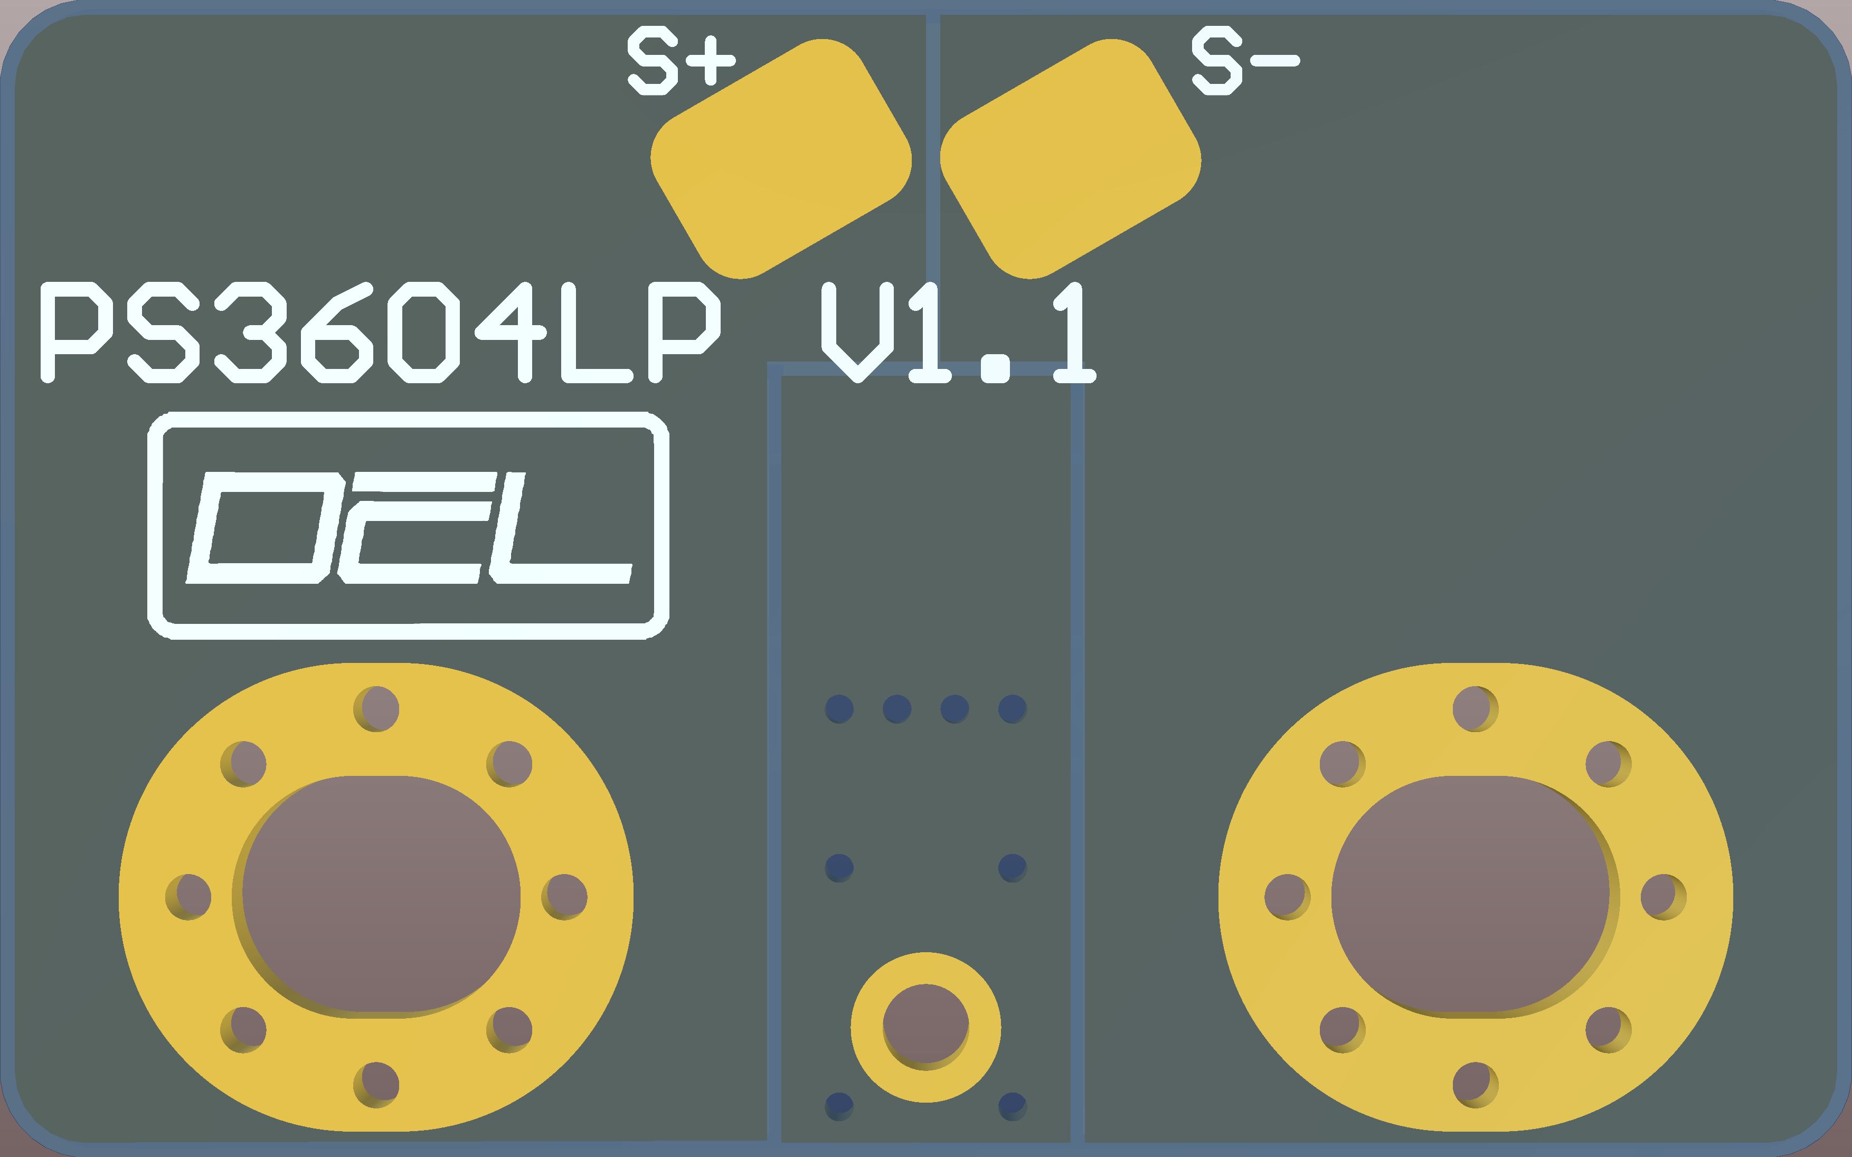
[picture p27: page 5]
