d-el/PS3604L/LTspice/regulator/regulator.asc

C1: cap; 0.1µ
C2: cap; 330p
C3: cap; 150p
C4: cap; 680p
D1: diode; 1N4148
D2: diode; 1N4148
D3: diode; 1N4148
D4: diode; 1N4148
D5: schottky; MBR20100CT
D6: schottky; MBR20100CT
D7: schottky; MBR20100CT
J1: njf; 2N3819
L1: ind; 0.001µ
M1: nmos; irf3710
M2: nmos; irf3710
M3: nmos; irf3710
M4: nmos; irf3710
M5: nmos; irf3710
M6: nmos; irf3710
M7: pmos; IRF7204
Q1: npn; BC817-16
Q2: npn; 2N5550
Q3: npn; 2N5550
Q4: npn; 2N5550
Q5: npn; 2N5550
Q6: npn; 2N5550
Q7: npn; 2N5550
R1: res; 680
R2: res; 100k
R3: res; 0.05
R4: res; 2k2
R5: res; 8k45
R6: res; 1k
R7: res; 8k45
R8: res; 2k2
R9: res; 2k2
R10: res; 2k2
R11: res; 8.2k
R12: res; 1k
R13: res; 100
R14: res; 2k2
R15: res; 2k2
R16: res; 2k2
R17: res; 100k
R18: res; 2k2
R19: res; 2k2
R20: res; 255
R21: res; 1
R22: res; 2k2
R23: res; 2k2
R24: res; 12k
R25: res; 75
R26: res; 25m
R27: res; 25m
R28: res; 50m
R29: res; 12k
R30: res; 180
R31: res; 75k
R32: res; 100k
R33: res; 0
R34: res; 0
R35: res; 6.2k
R37: res; 5
R39: res; 100k
S1: sw; MYSW
U1: AD8421
U2: AD8605
U3: AD8605
U4: AD8605
U5: AD8421
U6: AD8605
U7: AD8605
U8: AD8605
V1: voltage; 5
V2: voltage; -5
V3: voltage; 3.3
V4: voltage; 0.05
V5: voltage; SINE(12 1 100); Rser=0.1
V6: voltage; 12; Rser=0.1
V7: voltage; 12; Rser=0.1
V8: voltage; 12; Rser=0.1
V9: voltage; 16; Rser=2
V10: voltage; 3
V11: voltage; PULSE(0 3 50u 0 0 10s 0 1)
V12: voltage; PULSE(0 10 200u 0 0 100u 1 1)
V13: voltage; PULSE(5 0 50u 0 0 10s 0 1)
Named nets: 0, +5V, -5V, +3.3VA, VOFFSET, V1, V2, V3, V4, VG, ISET, VSET, MEASL, S+, S-
.tran 0 0.5m 0 0.01 startup
.options abstol=1e-10
.options reltol=0.003
Wire
Fuse
.inc irf3710.lib
Soft start
.model MYSW SW()
