d-el/PS3604L/(list of files, drawings)

Other design files:
OrCad/rectifier/RECTIFIER.DSN
OrCad/rectifier/rectifier.opj
OrCad/regulator/OUTAMP.DSN
OrCad/regulator/outamp.opj
Other/Trans.spl7
PCB/Panelization/Panelization.PcbDoc
PCB/Panelization/Panelization.PrjPcb
PCB/PS3604LD/PS3604LD.PcbDoc
PCB/PS3604LD/PS3604LD.PrjPcb
PCB/PS3604LD/PS3604LD.SchDoc
PCB/PS3604LF/PS3604LF.PrjPcb
PCB/PS3604LF/PS3604LF.SchDoc
PCB/PS3604LP/PS3604LP.PcbDoc
PCB/PS3604LP/PS3604LP.PrjPcb
PCB/PS3604LP/PS3604LP.SchDoc
PCB/PS3604LR/PS3604LR.PrjPcb
PCB/PS3604LR/PS3604LR.SchDoc
PCB/PS3604LRCF/PS3604LRCF.PcbDoc
PCB/PS3604LRCF/PS3604LRCF.PrjPcb
PCB/PS3604LRCF/PS3604LRCF.SchDoc
