d-el/PS3604L/Firmware/CubeProj_Regulator/PS3604R_F.ioc

Mcu.UserName=STM32F373CCTx
PA0.Signal=GPXTI0
PA1.GPIO_Label=RNG
PA1.Signal=GPIO_Input
PA10.Signal=USART1_RX
PA12.GPIO_Label=NSS3
PA12.Signal=GPIO_Output
PA13.Signal=SYS_JTMS-SWDIO
PA14.Signal=SYS_JTCK-SWCLK
PA15.Signal=SPI3_NSS
PA2.Signal=USART2_TX
PA4.Signal=COMP_DAC11_group
PA8.GPIO_Label=RNG_OVF
PA8.Signal=GPIO_Input
PA9.GPIO_Label=USART1_TX
PA9.Signal=USART1_TX
PB1.Signal=SDADC1_AIN5P
PB14.Signal=SDADC3_AIN8P
PB15.Signal=SDADC3_AIN7P
PB2.Signal=SDADC1_AIN4P
PB3.Signal=SPI3_SCK
PB4.Signal=SPI3_MISO
PB5.Signal=SPI3_MOSI
PB7.GPIO_Label=ON/OFF
PB7.Signal=GPIO_Output
PB8.Signal=USART3_TX
PB9.Signal=USART3_RX
PD8.Signal=SDADC3_AIN6P
PE8.Signal=SDADC1_AIN8P
PE9.Signal=SDADC1_AIN7P
PF0-OSC_IN.Signal=RCC_OSC_IN
PF1-OSC_OUT.Signal=RCC_OSC_OUT
PF6.GPIO_Label=LED
PF6.Signal=GPIO_Output
PF7.GPIO_Label=NSS2
PF7.Signal=GPIO_Output
