d-el/PS3604L/(commit log)

2018-03-15 Update repo
    [CULERREG.DSN, CulerReg.sch, CulerReg2.sch, DESIGN1.DSN, DESIGN2.DSN, Design1.opj, Design2.opj, PS3604LD.PcbDoc]
2018-03-22 Update fw & hw
    [OUTAMP.DSN, PS3604LD.PcbDoc, PS3604LF.SchDoc, PS3604LRCF.PcbDoc, outamp.opj]
2018-09-18 Update PCB
    [PS3604LD.PcbDoc, PS3604LD.PrjPcb, PS3604LF.PrjPcb, PS3604LF.SchDoc, PS3604LR.PrjPcb, PS3604LR.SchDoc, PS3604LRCF.PcbDoc, Panelization.PcbDoc]
2019-03-20 Next hardware revision
    [PS3604LD.PcbDoc, PS3604LD.PrjPcb, PS3604LD.SchDoc, PS3604LF.PrjPcb, PS3604LF.SchDoc, PS3604LR.PrjPcb, PS3604LR.SchDoc, PS3604LRCF.PcbDoc]
2019-03-21 Fix part number LAN transformer
    [PS3604LF.SchDoc]
2019-03-28 Update doc
    [PS3604LD.PcbDoc, PS3604LD.SchDoc, PS3604LF.SchDoc, PS3604LR.SchDoc, PS3604LRCF.SchDoc]
2019-03-28 Add BOM
    [Bill of Materials-PS3604LD.xls, Bill of Materials-PS3604LF.xls, Bill of Materials-PS3604LR.xls, Bill of Materials-PS3604LRCF.xls]
2020-10-17 update PCB and Firmware
    [PS3604LD.PrjPcb, PS3604LF.PrjPcb, PS3604LR.PrjPcb, PS3604LRCF.PrjPcb, Panelization.PrjPcb, rectifier.opj]
2023-07-23 update regulator board and firmware
    [Bill of Materials-PS3604LD.xls, Bill of Materials-PS3604LF.xls, PS3604LR.SchDoc]
2023-11-24 Add new files and add README
    [PS3604LR.SchDoc]
2023-12-21 Update Regulator firmware Add python API
2024-08-02 Update firmware; Update regulator PCB; Update OrCad model; Update README;
    [OUTAMP.DSN, PS3604LP.PcbDoc, PS3604LP.PrjPcb, PS3604LP.SchDoc, PS3604LR.PrjPcb, PS3604LR.SchDoc, RECTIFIER.DSN, outamp.opj]
2024-08-03 Update firmware; Update photo; Add OrCad regulator model;
    [OUTAMP.DSN, PAGE1.DXF, outamp.opj]
2024-08-03 Add OrCad rectifier model
    [RECTIFIER.DSN, rectifier.opj]
2024-08-15 Add calibration points; Update firmware;
2024-12-05 Minor fix on PCB
    [PS3604LD.PcbDoc, PS3604LF.SchDoc, PS3604LP.PcbDoc]
2025-04-18 Update regulator
    [PS3604LR.PrjPcb, PS3604LR.SchDoc]
2025-04-18 Update OrCAD regulator model
    [OUTAMP.DSN, outamp.opj]
2025-04-25 Update PCB files
    [Bill of Materials-PS3604LD.xls, Bill of Materials-PS3604LF.xls, Bill of Materials-PS3604LRCF.xls, PS3604LD.PrjPcb, PS3604LF.PrjPcb, PS3604LR.SchDoc]
2025-06-21 Update parameter in schematic
    [PS3604LR.PrjPcb, PS3604LR.SchDoc]
2025-07-16 Update Panel; Add current range to API;
2025-07-31 Update Regulator firmware; Add Information to README;
2025-09-11 Update scripts; Update Regulator; Update Firmware; Remove unused files;
    [PS3604LR.SchDoc]
2025-09-16 Update PS3604LP; Minor fix PS3604LR;
    [PS3604LP.PcbDoc, PS3604LP.PrjPcb, PS3604LP.SchDoc]
2025-10-02 Update logo in Panel, Regulator schematic, Protection unit schematic
    [PS3604LP.PrjPcb, PS3604LP.SchDoc, PS3604LR.SchDoc]
2025-10-27 Migrate to two DACs AD5060; Add current source to load output stage;
    [Bill of Materials-PS3604LR.xlsx, PS3604LD.PrjPcb, PS3604LR.PrjPcb, PS3604LR.SchDoc]
2025-11-03 Update Regulator firmware
2025-11-04 Fix read target_current; Add vfilter_size and ifilter_size;
    [ps3604l.py]
2025-11-04 Add script for Measure MOSFET Output Characteristics
2025-12-18 Add Regulator Acquisition settings
2026-05-26 Updated for the new regulator (V3.5)
    [Bill of Materials-PS3604LR.xlsx, PS3604LR.SchDoc]
2026-05-26 Update regulator photo
